aarnavshah12/Package-Track/esp32_lockbox/credentials.example.h

// Copy this file to credentials.h and fill in your Wi-Fi details.
// credentials.h is gitignored so your password never reaches the repo.
const char* WIFI_SSID     = "YOUR-WIFI-NAME";
const char* WIFI_PASSWORD = "YOUR-WIFI-PASSWORD";
