aarnavshah12/Package-Track/(commit log)

2026-07-14 Porch lockbox: vision client, Roboflow workflow, ESP32 firmware
    Phases A+B complete: RF-DETR porch detection via the aarnavs-space/package-track
    serverless workflow, client-side delivery state machine (dwell -> 5s pre-open ->
    13s self-closing delivery window -> verification -> events), ESP32 relay firmware
    with thermal watchdog, and Vision Events + dataset-upload recording.
2026-07-15 Phase C: iOS app with on-device wake gate, ported state machine, activity feed, ntfy push notifications
    - ios/: the window-camera app (SPM + Roboflow SDK 1.2.7, RF-DETR on-device)
    - tiered wake gate: vehicle arrival / person+package / person streak
    - LockboxBrain: 1:1 port of the Python state machine, hardened by
    adversarial review (14 findings fixed incl. starter's stuck-flag bug)
    - local activity feed with photos; keep-awake kiosk mode
    - workflow: webhook_sink -> ntfy push notifications on delivery events
    (replaces the descoped email); notification copy cleanup
    - clients send ntfy_topic; secrets templated (LockboxSecrets.example)
2026-07-15 Household dashboard: LAN server + live view + event gallery + lock controls
    - dashboard/server.js: zero-dependency Node server on the Mac (port 8321) -
    receives frame mirror + event photos from the camera phone, proxies
    open/pulse/status to the ESP32, serves the dashboard page
    - dashboard/index.html: live porch view, lock state, open/pulse buttons,
    activity gallery
    - iOS: DashboardClient mirrors streamed frames (~1/s awake) and event
    photos to the dashboard, best-effort
2026-07-15 Dashboard v2: real MJPEG live stream, token auth, remote commands, design rework
    - server: multipart MJPEG /api/stream (true motion video), token-protected
    endpoints, command queue executed by the camera phone (works on any host -
    Mac LAN or cloud), direct ESP32 path when on the home network
    - UI: full redesign - compact camera panel, live badge, clean activity list,
    access-key gate for public hosting
    - iOS: viewer-aware mirroring (8 fps while watched, heartbeat otherwise),
    dashboard command execution (open/pulse/box-emptied from anywhere)
2026-07-15 Dashboard: bind buttons via listeners (extension/cache-proof), safe storage access
2026-07-15 Compress event photos on-device (~960px q0.6) + bounded image storage on the server
2026-07-15 Mirror-correct front-camera overlay; dashboard is now view-only (command endpoint removed)
2026-07-15 Controls belong on the dashboard, not the window phone: restore dashboard buttons + command relay, strip lock controls from the camera app (Activity kept)
2026-07-15 Re-apply portrait rotation after camera switches (connection resets on input swap)
2026-07-16 README: swap ASCII architecture sketch for the delivery-flow diagram
2026-07-16 README: dark version of the delivery-flow diagram
2026-07-16 Expand porch zone 1.2x from centroid - tight trace was clipping detections
2026-07-16 Zone: simple full-width rectangle over the bottom 3/4 of the frame
2026-07-16 Match cloud per-class confidences to the on-device threshold (0.5)
2026-07-16 Zone: full frame while debugging detection
2026-07-17 Revert "Zone: full frame while debugging detection"
    This reverts commit 8753636e5aedee1b509946667ffa4e06c8d19d8b.
